mkovero/7226ctrl/schematics.png

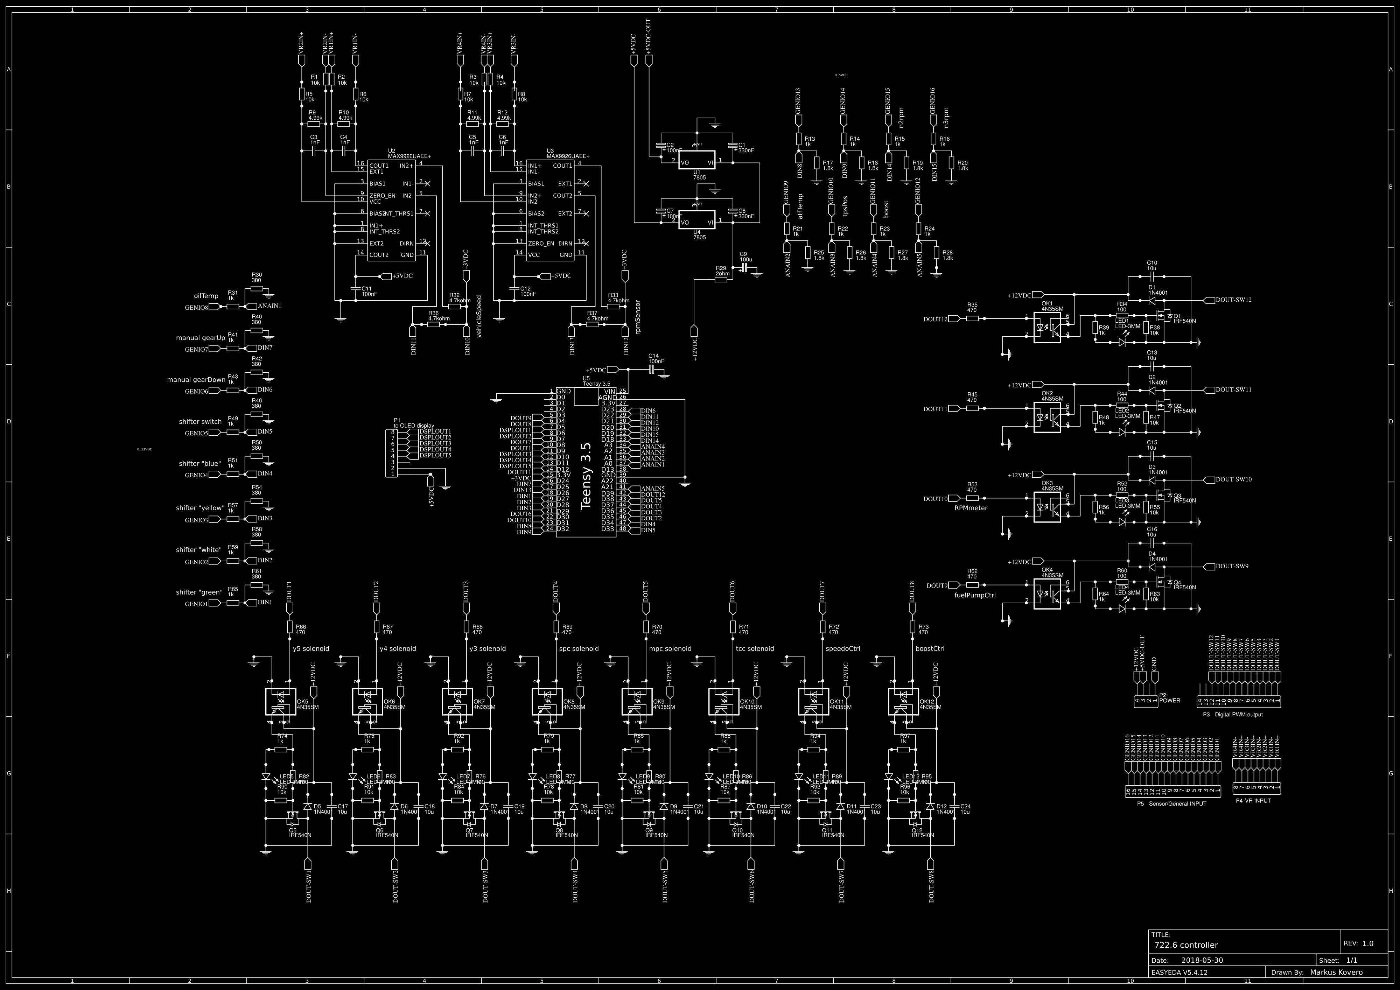
schematics.png
