mkovero/7226ctrl/pcb/bom_K.xls

722SMD2-HIGHPREC
Mouser No | Mfr. No | Manufacturer | Customer No | Description | RoHS | Lifecycle | Order Qty. | Price (EUR) | Ext.: (EUR)
474-DEV-14056 | DEV-14056 | SparkFun Electronics |  | Development Boards & Kits - ARM Teensy 3.5 (Headers) | RoHS Compliant |  | 1 | 28,38 € | 28,38 €
595-CD4504BPWR | CD4504BPWR | Texas Instruments |  | Translation - Voltage Levels Hex Voltage | RoHS Compliant |  | 2 | 0,419 € | 0,84 €
511-L78M05CDT-TR | L78M05CDT-TR | STMicroelectronics |  | Linear Voltage Regulators 5.0V 0.5A Positive | RoHS Compliant |  | 2 | 0,402 € | 0,80 €
700-MAX9926UAEE/V+ | MAX9926UAEE/V+ | Maxim Integrated |  | Sensor Interface Variable-Reluctance Sensor Interface | RoHS Compliant |  | 2 | 10,93 € | 21,86 €
603-RC0603FR-07383RL | RC0603FR-07383RL | Yageo |  | Thick Film Resistors - SMD 383 OHM 1% | RoHS Compliant By Exemption |  | 7 | 0,087 € | 0,61 €
603-RC0603FR-07280RL | RC0603FR-07280RL | Yageo |  | Thick Film Resistors - SMD 280 OHM 1% | RoHS Compliant |  | 1 | 0,087 € | 0,09 €
603-RC0603FR-07220RL | RC0603FR-07220RL | Yageo |  | Thick Film Resistors - SMD 220 OHM 1% | RoHS Compliant By Exemption |  | 1 | 0,087 € | 0,09 €
603-RC0603FR-071K8L | RC0603FR-071K8L | Yageo |  | Thick Film Resistors - SMD 1.8K OHM 1% | RoHS Compliant |  | 8 | 0,087 € | 0,70 €
942-IRF540NSTRLPBF | IRF540NSTRLPBF | Infineon |  | MOSFET MOSFT 100V 33A 44mOhm 47.3nC | RoHS Compliant |  | 12 | 1,09 € | 13,08 €
755-SMLEN3WBC8W1 | SMLEN3WBC8W1 | ROHM Semiconductor |  | Standard LEDs - SMD White 10mA; 120mcd 0603; 10mA; 33mW Pd | RoHS Compliant | New Product | 12 | 0,252 € | 3,02 €
576-AQ4020-01FTG | AQ4020-01FTG | Littelfuse |  | ESD Suppressors / TVS Diodes 30A 2.5pF AEC-Q101 | RoHS Compliant | New Product | 12 | 0,41 € | 4,92 €
621-1N5819HW-F | 1N5819HW-7-F | Diodes Incorporated |  | Schottky Diodes & Rectifiers Vr/40V Io/1A T/R | RoHS Compliant |  | 14 | 0,252 € | 3,53 €
650-MINISMDC110F/24 | MINISMDC110F/24-2 | Littelfuse |  | Resettable Fuses - PPTC 24V 1.1A-HD 40A MAX | RoHS Compliant |  | 2 | 0,445 € | 0,89 €
667-EEU-FR1E102L | EEU-FR1E102L | Panasonic |  | Aluminium Electrolytic Capacitors - Radial Leaded 25VDC 1000uF 10x25mm LS5mm | RoHS Compliant |  | 1 | 0,821 € | 0,82 €
810-CGA4J2X8R1E334KA | CGA4J2X8R1E334K125AE | TDK |  | Multilayer Ceramic Capacitors MLCC - SMD/SMT SOFT 0805 25V 0.33uF X8R 10% AEC-Q200 | RoHS Compliant |  | 2 | 0,279 € | 0,56 €
810-C2012X7T2E104MST | C2012X7T2E104M125AE | TDK |  | Multilayer Ceramic Capacitors MLCC - SMD/SMT SOFT 0805 250V 0.1uF X7T 20% T: 1.25mm | RoHS Compliant |  | 7 | 0,349 € | 2,44 €
810-CGA4C4C0G2W102J0 | CGA4C4C0G2W102J060AE | TDK |  | Multilayer Ceramic Capacitors MLCC - SMD/SMT 0805 C0G 450V 1nF 5% SOFT C0G AEC-Q200 | RoHS Compliant | New Product | 4 | 0,297 € | 1,19 €
603-RC0603FR-072KL | RC0603FR-072KL | Yageo |  | Thick Film Resistors - SMD 2K OHM 1% | RoHS Compliant |  | 16 | 0,016 € | 0,26 €
603-RC0603FR-07100RL | RC0603FR-07100RL | Yageo |  | Thick Film Resistors - SMD 100 OHM 1% | RoHS Compliant |  | 12 | 0,016 € | 0,19 €
603-RC0603FR-074K7L | RC0603FR-074K7L | Yageo |  | Thick Film Resistors - SMD 4.7K OHM 1% | RoHS Compliant |  | 9 | 0,087 € | 0,78 €
603-RC0603FR-0710KL | RC0603FR-0710KL | Yageo |  | Thick Film Resistors - SMD 10K OHM 1% | RoHS Compliant |  | 20 | 0,016 € | 0,32 €
603-RC0603FR-071KL | RC0603FR-071KL | Yageo |  | Thick Film Resistors - SMD 1K OHM 1% | RoHS Compliant |  | 16 | 0,016 € | 0,26 €
