mkovero/7226ctrl/pcb/bom_H.xls

Comment | Description | Designator | Footprint | LibRef | Quantity
330nF |  | C1, C8 | 330NF TDK |  | 2.0
100nF |  | C2, C7, C11, C12, C14 | 0.1UF TDK |  | 5.0
1nF |  | C3, C4, C5, C6 | RAD-0.1 |  | 4.0
1000uF | EEUFR1E102 | C9 | 1000UF PANASONIC |  | 1.0
EXT CONN |  | CANBUS/SERIAL | HDR-4X1/2.54 |  | 1.0
1N4001 |  | D1, D2, D3, D4, D5, D6, D7, D8, D9, D10, D11, D12 | DIODE_DO35 |  | 12.0
to OLED display |  | Display | HDR-8X1/2.54 |  | 1.0
Sensor/General INPUT |  | GENERAL INPUT | HDR1X16 |  | 1.0
LED-3MM |  | LED1, LED2, LED3, LED4, LED5, LED6, LED7, LED8, LED9, LED10, LED11, LED12 | LED-3MM/2.54 |  | 12.0
4N35SM |  | OK1, OK2, OK3, OK4, OK5, OK6, OK7, OK8, OK9, OK10, OK11, OK12 | DIL6-SMD |  | 12.0
VR INPUT2 |  | P6 | HDR-4X1/2.54 |  | 1.0
VR INPUT1 |  | P7 | HDR-4X1/2.54 |  | 1.0
POWER |  | PWR | HDR-4X1/2.54 |  | 1.0
IRF540N |  | Q1, Q2, Q3, Q4, Q5, Q6, Q7, Q8, Q9, Q10, Q11, Q12 | TO-263-2 |  | 12.0
10k |  | R1, R2, R3, R4, R5, R6, R7, R8, R38, R47, R55, R63, R78, R81, R84, R87, R90, R91, R93, R96 | AXIAL-0.3_2 |  | 20.0
4.99k |  | R9, R10, R11, R12 | AXIAL-0.3_2 |  | 4.0
1k |  | R13, R14, R15, R16, R21, R22, R23, R24, R31, R39, R41, R43, R48, R49, R51, R56, R57, R59, R64, R65, R74, R75, R79, R85, R88, R92, R94, R97 | AXIAL-0.3_2 |  | 28.0
1.8k |  | R17, R18, R19, R20, R25, R26, R27, R28 | AXIAL-0.3_2 |  | 8.0
2ohm |  | R29 | AXIAL-0.3_2 |  | 1.0
380 |  | R30, R40, R42, R46, R50, R54, R58, R61 | AXIAL-0.3_2 |  | 8.0
4.7kohm |  | R32, R33, R36, R37 | AXIAL-0.3_2 |  | 4.0
100 |  | R34, R44, R52, R60, R76, R77, R80, R82, R83, R86, R89, R95 | AXIAL-0.3_2 |  | 12.0
470 |  | R35, R45, R53, R62, R66, R67, R68, R69, R70, R71, R72, R73 | AXIAL-0.3_2 |  | 12.0
7805 |  | U1, U4 | TO252 |  | 2.0
MAX9926UAEE+ |  | U2, U3 | QSOP-16_150MIL |  | 2.0
Teensy 3.5 |  | U5 | TEENSY 3.5 |  | 1.0
