mkovero/7226ctrl/(threads)

Thread 1 (2018-02-25):

Schematic - transistors

thundercat, 2018-02-25:
Hi
I have few remark.
IRF540 need Vgs = ~10V to full open
to drive transistor direct from arduino pin you have to use Logic Level mosfet eg. IRFZ44N or use mosfet driver TC4427.
You have to protect transistors by diodes,
swap on schematic drain pin with source pin because now is incorrect.
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

best regards

mkovero, 2018-03-11:
Thanks for feedback, I'm actually using 4 channel mosfet boards on the actual circuit and schematic is guiding so to say. I'll fix this next week accordingly.
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

Thread 2 (2018-06-06):

vehicleSpeed safety checks

mkovero, 2018-06-06:
- compare speed differences in RPM-vehicleSpeed and or differential sensor-vehicleSpeed to determine whether vehicleSpeed is accurate.
- if not, or no speed data available, disable automatic shifting.

mkovero, 2018-06-11:
fixed in https://github.com/mkovero/7226ctrl/commit/2de3873fe0690ee71ed6efa9559b21a33d5eaf03

Closed 2018-06-11.

Thread 4 (2018-06-06):

Create hardware test-mode

mkovero, 2018-06-06:
Idea is to create simple test mode for controller to see if wiring is alright.
- test sensors / solenoids / actuators (test that tps is in range, if not, calibrate it etc.)
- display test / align (support for different displays people might have)

dvjcodec, 2018-11-19:
I use simple sketch for tests outputs in my controller. Just add LCD output with test graphics.
https://drive.google.com/file/d/1jQX9WTmhtOgBZNdRIwTGqzLBBpeP_FXw/view?usp=sharing

int led = 19;   //speed1
int led2 = 18;  //speed2
int led3 = 24;  //speed3
int led4 = 35;  //selenoid1
int led5 = 37;  //selenoid2
int led6 = 41;   //selenoid3
int led7 = 43;  //selenoid4
int led8 = 39;   //selenoid5
int led9 = 29;   //selenoid6
int led10 = 31;   //selenoid7
int led11 = 33;   //selenoid8
int led12 = 2;  //MCP int
int led13 = 0;   //
int led14 = 0;  //
int led15 = 0;  //
int led16 = 0;  //
int led17 = 0;  //
int led18 = 0;  //
int led19 = 0;  //

void setup() {       
// initialize the digital pin as an output.
pinMode(led, OUTPUT);
pinMode(led2, OUTPUT);
pinMode(led3, OUTPUT);
pinMode(led4, OUTPUT);
pinMode(led5, OUTPUT);
pinMode(led6, OUTPUT);
pinMode(led7, OUTPUT);
pinMode(led8, OUTPUT);
pinMode(led9, OUTPUT);
pinMode(led10, OUTPUT);
pinMode(led11, OUTPUT);
pinMode(led12, OUTPUT);
pinMode(led13, OUTPUT);
pinMode(led14, OUTPUT);
pinMode(led15, OUTPUT);
pinMode(led16, OUTPUT);
pinMode(led17, OUTPUT);
pinMode(led18, OUTPUT);
pinMode(led19, OUTPUT);
}

void loop()
{digitalWrite(led, HIGH);   // turn the LED on (HIGH is the voltage level)
delay(50);                 // wait for a second
digitalWrite(led, LOW);     // turn the LED off by making the voltage LOW
delay(50);                 // wait for a second

{digitalWrite(led2, HIGH);
delay(50);
digitalWrite(led2, LOW);
delay(50);}

{digitalWrite(led3, HIGH);
delay(50);
digitalWrite(led3, LOW);
delay(50);}

{digitalWrite(led4, HIGH);
delay(50);
digitalWrite(led4, LOW);
delay(50);}

{digitalWrite(led5, HIGH);
delay(50);
digitalWrite(led5, LOW);
delay(50);}

{digitalWrite(led6, HIGH);
delay(50);
digitalWrite(led6, LOW);
delay(50);}

{digitalWrite(led7, HIGH);
delay(50);
digitalWrite(led7, LOW);
delay(50);}

{digitalWrite(led8, HIGH);
delay(50);
digitalWrite(led8, LOW);
delay(50);}

{digitalWrite(led9, HIGH);
delay(50);
digitalWrite(led9, LOW);
delay(50);}

{digitalWrite(led10, HIGH);
delay(50);
digitalWrite(led10, LOW);
delay(50);}

{digitalWrite(led11, HIGH);
delay(50);
digitalWrite(led11, LOW);
delay(50);}

{digitalWrite(led12, HIGH);
delay(50);
digitalWrite(led12, LOW);
delay(50);}

{digitalWrite(led13, HIGH);
delay(50);
digitalWrite(led13, LOW);
delay(50);}

{digitalWrite(led14, HIGH);
delay(50);
digitalWrite(led14, LOW);
delay(50);}

{digitalWrite(led15, HIGH);
delay(50);
digitalWrite(led15, LOW);
delay(50);}

{digitalWrite(led16, HIGH);
delay(50);
digitalWrite(led16, LOW);
delay(50);}

{digitalWrite(led17, HIGH);
delay(50);
digitalWrite(led17, LOW);
delay(50);}

{digitalWrite(led18, HIGH);
delay(50);
digitalWrite(led18, LOW);
delay(50);}

{digitalWrite(led19, HIGH);
delay(50);
digitalWrite(led19, LOW);
delay(50);}

}

mkovero, 2018-11-19:
thanks for this; INPUTs would require similar functionality, also sensor calibration would need some thought (pressure sensors, tps, temp sensors)

Thread 5 (2018-09-11):

Libraries

ikulic, 2018-09-11:
Hi,can you upload your necessary library folder for that code? I have problem with compiling with last version of Arduino IDE.

mkovero, 2018-09-14:
Hi, Yes I have to check best way to include libraries, external dependencies are as follows:
https://github.com/prampec/arduino-softtimer for softtimer.h
https://github.com/olikraus/u8g2 for U8g2lib.h
http://ryandowning.net/AutoPID/ for AutoPID.h

ikulic, 2018-09-14:
Now it is working,thank you. If you need some help with this project,you can contact me. Now I am working on two 722.6 transmision,I just waiting for pcb to manufacture. I will put that transmission on om606 and we will see.

Closed 2018-09-16.

Thread 13 (2019-02-15):

Pins for Arduino mega?

bendeguztanczos, 2019-02-15:
Hi all! Anyone try it on Arduino mega? I thought I make a full smd board with atmega2560. Anyone have pins.h for arduino mega? And how well it is run on mega or i need teensy?

mkovero, 2019-03-17:
I used to develop this on arduino mega, but unfortunately there are few quite heavy float calculation nowadays and I'm afraid that mega wont perform enough to handle it not to mention it would not have enough available memory to even try to run the code. Teensy 3.5 is highly recommended.

Closed 2019-03-17.

Thread 15 (2019-04-12):

Read gear number from CAN.

Amarok73, 2019-04-12:
Hello Markus,

May I ask You, if You know how to read the gear number, lock-up state and gearbox oil temperature from the CAN (preferably through OBDII)?
I am using Jeep WG with this gearbox for around 3 years now, and since beginning I have idea to prepare Arduino based indicator of these values.
I was trying unsuccessfully to sniff messages and analyze them, and when i lost my hope, there appeared new version of JeepDiagPro, that was showing these values.
I know from Krzysztof Dymaniuk, that it wasn't so far in the scope of Your engineering, but perhaps as You already have all needed facilities it would be easier for You to investigate it?
I'd really appreciate if You can share anything substantial, as this fight with obsession i feel i am loosing slowly... :-)

astam1, 2019-04-23:
Doing this through the ODBII is going to be very difficult. Most likely your vehicle has a module that acts like a gateway from the OBDII to the internal can network(s). This is typically secured so that a sort of "code" is needed. Only standard OBD PIDs will be available via OBDII without the manufacturers "code".

I have an XK that uses the same transmission. Using a tap into the power train bus can tell you in the 06 XK the tcm transmits base 10 can ids 536, 824, 1048, 1312. At least in this application the current gear does not appear to be transmitted on the bus. Most of the messages are not decipherable. Code 824 contains the input shaft speed. In my vehicle there is no manual shift mode, only a mode that selected the highest available gear. The 1,2,3,4,5 displayed on the cluster is simply the highest gear available and is read from the shift control module.

I have used an app called "obd jscan" which is able to get the atf temperature. It works through the obd port. You could possible get the obd2 "code" for your car my sniffing the obd2 port while running the app. At least when I last used it, it didn't show the current gear or lock-up state.

Lastly what is a jeep WG? Did you mean WK, WK2, XK, WK?

Amarok73, 2019-05-13:
Hello @astam1, thank You for Your comment.
Jeep WG is the Grand Cherokee 2 released on European market. The WJ is the same but on the USA.
I have tried couple of scanners, but so far, analyzing the dumps I wasn't able to find anything that could possibly be identified as the messages I am interested about, so I am affraid that these PIDs are only returning values instead of broadcasting these parameters.

astam1, 2019-05-17:
Alright so the vehicle is a diesel WJ with the 722.6? It sounds like you are using the OBDII port to try to get the current transmission gear. It is likely that the PID for current transmission gear is not supported on that vehicle (not supported on mine either). If this is the case there is no easy way to get the current gear.

This information may be on the internal can bus between the TCM and ECU but you would have to splice into it to find out and it may not be available their either. If you are interested in the internal bus you may find [this](http://connectors.dcctools.com/home.htm) useful. If you type in your year and select WJ you can find the connector pinouts. Using this you can locate the can bus that you would need to tap into. Do this at your own risk though.

dvjcodec, 2019-05-19:
Gear number is coded in ID218 (I was read from Mercedes W210 CANbus network). ID218 is Transmission Control Unit.
Sample message --> ID218 6 FE 20 11 40 AA 09
20 - is a shifter position (same like W202)
11 - gear number
40 - no kickdown / with kickdown is 44
AA - probably torque status, because is growing up when car accelerate and stop on AA or 64 when speed stable (doesnt matter what gear).
I have a lot recorded CANbus messages from my car and will put all info on my Github
https://github.com/dvjcodec/Mercedes-W210-CAN-bus

Amarok73, 2019-05-19:
So far, I've found that my Arduino + CanBus Shield "sandwich" is ok (tested successfully on Volvo V40), so reason that it is not returning anything from OBD2 socket seems to be somewhere else. It may be, that CAN pins in socket are disabled - not connected.
I'll try to get CAN signal from radio harness, but still i have feeling, that documentation for these "features" in my Jeep model is really tough to find in the Internet.

dvjcodec, 2019-05-19:
Connect direct to TCU's wires. CAN-bus can't be disabled, because is diagnostic data for all systems in your Jeep WJ. If U have ELM327 U can test connection between OBDII and application. Use free diagnostic software (best for WJ 2.7CRD) --> https://jeepswj.com/software/.
I will try to connect to my W163 tomorrow.

Amarok73, 2019-05-20:
Krzysztof, I mentioned this software in my first post, and yes - it is possible to read all interresting me parameters using this software from OBD2 with Bluetooth interface connected. So in theory it's not needed to connect into any harness, it's just matter of knowing how to read these values from OBD socket. Here are some screenshots from the paid version of the JeepDiag software.
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

dvjcodec, 2019-05-21:
CAN-bus data direct from Transmission Control Unit (EGS52)
53,752 218      8 CC 40 FF 48 13 80 FF 51
53,769 338      8 FF FF 1F FF 00 FF 00 00
53,771 418      8 20 20 82 80 FF FF 7F FF
Tomorrow I will conect to my MB W163 and give U info about where is current gear.

Amarok73, 2019-05-21:
Which one is the PID, 218, 338 and 418?

dvjcodec, 2019-05-23:
My ML do not have CAN pins in OBDII connector (probably WJ 2.7 same). CAN-bus is an internal network between modules, not for diagnostic. All data to ELM327 diagnostic (with current parameters and DTC's is delivered from SAE J1850 pins --> http://www.interfacebus.com/Automotive_SAE_J1850_Bus.html

UKSFM99, 2019-12-08:
Hate to comment on an old issue, but this is luckily possible, depending on what Model car you have.

I'm the author of this project: https://github.com/UKSFM99/W203-canbus, and have actually used gear number reading for 722.6 in the W211/203/209 Series.

The following discoveries I've found on Bus B. Not Can C.

You should be able to read the gear number in CAN  PID 0x0003 (Its bits 12-16).

Additionally, Transmission fluid temperature can be read using PID 0x0222 (bits 0-8 aka Byte 1) within the frame. Doesn't seem to work on my W203 but does on my friends W211.

I am currently trying to reverse engineer Canbus C manually (Isolating the TCM to see what PIDS it sends). Will update if i find anything :)

Hope this helps!

kacperziolo, 2020-02-11:
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

Hi Krzysztof, could you share more informations about W210 AT CAN communication by any chance ? I'm swapping OM613 engine with 722.6 AT to 85' G-class and I need to make selected gear indicator for "tip-tronic" mode. Your data should help me a lot. Thanks you in advance

rnd-ash, 2020-02-15:
your mostly correct there!

I have decoded a Xentry SGS file which shows ALL the IDs stored within the 722.6 controller, there appears to be way more there than what you found out originally.

see here: https://github.com/rnd-ash/W203-canbus/blob/master/DAT_TRANSLATOR/DECODED/w203_w209%20CAN%20C%20ENGLISH.txt

and find the ECU called GS_218h as that's the ID message you found.

note though that all the GS_ ECU can messages are broadcast from the 722.6s controller, so you'll need to implement all of them.

I have opened a second issue here where I've dumped all the msg Params from the controller.

regards

Thread 16 (2019-09-24):

Schematic update for Rev K

bigdaveakers, 2019-09-24:
The schematic needs to be updated to to reflect the rev K board. The BOM is different for this revision and does not match the schematic.

bendeguztanczos, 2019-09-25:
I uploaded it to drive. I work on a new schematic and a pc software for view live data and adjust the controller. If you intrested email me on the drive email. https://drive.google.com/drive/folders/1ryEfBxrVVONnGXfy4Gf4tAIZiEu2R3jR?usp=sharing

bigdaveakers, 2019-09-25:
Thanks!!

Thread 17 (2019-09-29):

SMD Rev K assembled board photos

captncockwash, 2019-09-29:
Could somebody please share close up photos of assembled rev k board.
Finished mine yesterday, only half powered up, I have a dead short somewhere although I currently can’t find it. Would like to check component polarity against a working board before I decide it’s the PCB. Thanks!

captncockwash, 2019-09-30:
Short between PCB layers, cut out trace and used a jumper wire for 12v supply on one side. Fully functional now, will transfer to new board ASAP.

Closed 2019-09-30.

Thread 18 (2019-12-25):

Display pin out

captncockwash, 2019-12-25:
I’m trying to use a 7 pin SPI OLED. Could somebody please clarify the pin function for ‘DISPLAY 1’ to ‘DISPLAY 5’? Clk, MOSI, DC etc.

I’ve looked at the U8G2 stuff but fear I’m just going round and round in circles. Should the display boot as soon as power is applied to the board.

I’m a relative noob when it comes to the code.

Thank you in advance.

mkovero, 2020-02-27:
Are you referring to some pcb pinout or? which revision?

asaner20, 2021-12-22:
I have a similar question. I soldered the board from this github, revision K. I would like to know the pinout for
connect 7pin SPI OLED display. Without the ability to see data in real time, I cannot check the controller. I also have a question, maybe you have a PC program to configure the controller. I am a car enthusiast, I have knowledge of a mechanic, but in programming I am a noob

Thread 19 (2020-02-13):

ALL 722.6 TCU CAN MESSAGES

rnd-ash, 2020-02-13:
I found these ID's from a python script I wrote to decompile data found in Xentry:
https://github.com/rnd-ash/W203-canbus/blob/master/DAT_TRANSLATOR/parse_dat.py

These ID's are broadcast on CANBUS C - The ECU name is just the name of the message in Xentry, but they all come from the GS controller (AKA TCU) - Original text was in German so most of it has been translated :)

The offset and len in the messages are viewed from a big endian position within the can frame, where 0 is byte 0 and 64 is the 8th bit in the 8th byte

ECU NAME: GS_218h, ID: 0x0218. MSG COUNT: 31
	MSG NAME: MTGL_EGS - Motormomentenanf. Toggle 40ms +-10, OFFSET 0, LENGTH 1
	MSG NAME: MMIN_EGS - Engine torque requirment Min, OFFSET 1, LENGTH 1
	MSG NAME: MMAX_EGS - Engine torque requirment Max, OFFSET 2, LENGTH 1
	MSG NAME: M_EGS - Current engine torque, OFFSET 3, LENGTH 13
	MSG NAME: GZC - Target gear, OFFSET 16, LENGTH 4
	MSG NAME: GIC -Current gear, OFFSET 20, LENGTH 4
	MSG NAME: K_S_B - torque converter slipping, OFFSET 24, LENGTH 1
	MSG NAME: K_O_B - torque converter open, OFFSET 25, LENGTH 1
	MSG NAME: K_G_B - torque converter closed, OFFSET 26, LENGTH 1
	MSG NAME: G_G - off road gear, OFFSET 27, LENGTH 1
	MSG NAME: GSP_OK - gear shift program o.k., OFFSET 28, LENGTH 1
	MSG NAME: FW_HOCH - Driving resistance too high, OFFSET 29, LENGTH 1
	MSG NAME: SCHALT - Schaltung, OFFSET 30, LENGTH 1
	MSG NAME: HSM - Manual shift mode active, OFFSET 31, LENGTH 1
	MSG NAME: GET_OK - Transmission ok, OFFSET 32, LENGTH 1
	MSG NAME: KS - Knallstart, OFFSET 33, LENGTH 1
	MSG NAME: ALF - start enabled, OFFSET 34, LENGTH 1
	MSG NAME: GS_NOTL - Gearbox in limp home mode, OFFSET 35, LENGTH 1
	MSG NAME: UEHITZ_GET - Gearbox overheating, OFFSET 36, LENGTH 1
	MSG NAME: KD - Kickdown, OFFSET 37, LENGTH 1
	MSG NAME: FPC_AAD - Driving program for AAD, OFFSET 38, LENGTH 2
	MSG NAME: MPAR_EGS - Motor torque request parity (even parity) OFFSET 40, LENGTH 1
	MSG NAME: DYN1_EGS - Engagement mode / drive torque control, OFFSET 41, LENGTH 1
	MSG NAME: DYN0_AMR_EGS - Engagement mode / drive torque control OFFSET 42, LENGTH 1
	MSG NAME: K_LSTFR - Torque converter lockup free of load, OFFSET 45, LENGTH 1
	MSG NAME: MOT_NAUS_CNF - Confirm bit OFFSET 46, LENGTH 1
	MSG NAME: MOT_NAUS - Engine emergency stop, OFFSET 47, LENGTH 1
	MSG NAME: MKRIECH - creep torque (FF for EGS + CVT), OFFSET 48, LENGTH 8
	MSG NAME: FEHLPRF_ST - Status error check, OFFSET 56, LENGTH 2
	MSG NAME: CALID_CVN_AKT - CALID/CVN transmission active OFFSET 58, LENGTH 1
	MSG NAME: FEHLER - Error number counter, OFFSET 59, LENGTH 5
ECU NAME: GS_338h, ID: 0x0338. MSG COUNT: 2
	MSG NAME: NAB - Gearbox output speed (only 463/461, otherwise FFFF), OFFSET 0, LENGTH 16
	MSG NAME: NTURBINE - Turbine speed (NAG1/NAG2 only), OFFSET 48, LENGTH 16
ECU NAME: GS_418h, ID: 0x0418. MSG COUNT: 17
	MSG NAME: FSC - Driving position, OFFSET 0, LENGTH 8
	MSG NAME: FPC - Driving program, OFFSET 8, LENGTH 8
	MSG NAME: T_GET - Gearbox oil tempurature, OFFSET 16, LENGTH 8
	MSG NAME: ALLRAD - All wheel drive?, OFFSET 24, LENGTH 1
	MSG NAME: FRONT - Front wheel drive [1], Rear wheel drive [0], OFFSET 25, LENGTH 1
	MSG NAME: SCHALT - Schaltung, OFFSET 26, LENGTH 1
	MSG NAME: CVT - Stepless gears[1], Stepped gear [0], OFFSET 27, LENGTH 1
	MSG NAME: MECH - Gear mechanism varient, OFFSET 28, LENGTH 2
	MSG NAME: ESV_BRE - Apply brake when switched on, OFFSET 30, LENGTH 1
	MSG NAME: KD - Kickdown, OFFSET 31, LENGTH 1
	MSG NAME: GZC - Target gear, OFFSET 32, LENGTH 4
	MSG NAME: GIC - Actual gear, OFFSET 36, LENGTH 4
	MSG NAME: M_VERL - Torque loss, OFFSET 40, LENGTH 8
	MSG NAME: FMRADPAR - wheel torque (even parity), OFFSET 48, LENGTH 1
	MSG NAME: FMRADTGL - Factor wheel torque toggle 40ms + -10, OFFSET 49, LENGTH 1
	MSG NAME: WHST - Gear selector lever posititon (NAG, KSG, CVT), OFFSET 50, LENGTH 3
	MSG NAME: FMRAD - Wheel torque factor (FF for KSG), OFFSET 53, LENGTH 11

mkovero, 2020-02-27:
woot, thank you very much for these, will look into this at some point

rnd-ash, 2020-03-11:
no problem! I'm trying to make my own 722.6 TCU for my W203 as a hobby project (not using this code, sorry), but I thought I'd share those :)

Thread 20 (2020-09-19):

Possible collaberation on updated controller for 2001-2011 Mercs

rnd-ash, 2020-09-19:
Hi.

As you know, I posted all the 722.6 CAN messages to another issue on here. I would like to ask if you are up for collaborating on a more modern drop in replacement TCU for the 203-204 series vehicles (Basically anything with a 722.6 from 2001 to 2011).

I had some ideas on how to update your codebase for CAN compatibility, but it will also require PCB modifications to allow for CAN C Tx/Rx support.

I also wish to add adaptive learning based on a simple neural network that can run on the Teensy 4 board, and allow it to be trained in pure manual mode (M), the apply the learned values in both Sport, Comfort, or Agility mode (A is supported on all 722.6 transmissions, but it was only implemented on the 204 chassis). Due to it being on CANBUS, its possible to take into consideration a lot more sensors on the car before determining if it should shift. Just some of whats avaliable on CANBUS below:
1. Individual wheel RPM (all 4)
2. Steering wheel angle (Driver input)
3. Steering wheel angle (Wheel output)
4. Boost pressure
5 .Engine torque production (Nm)
6. ESP / ABS actuation values

In regards to determining shift pressure. I can make that user configurable in each mode (S/C/A), in fact i plan to enable configuration over CANBUS for my Headunit project, allowing me to adjust shift parameters from a touch screen within the car.

I've also updated the CAN messages below with data extracted from my MercedesUI project (Custom infotainment system for older mercs)...This contains additional parsed values for enum based data:
[7226_can.txt](https://github.com/mkovero/7226ctrl/files/5250090/7226_can.txt)

mkovero, 2020-11-21:
Excellent idea, can rx/tx already works but is restricted to single channel currently. We have been considering doing hardware / software redesign, so if you feel you are up to it you can create algorithm of your own that we can try.
I would prefer pure c++ instead of arduino and use of FreeRTOS helpers so realtime priorisation can be made properly. Refrain from using any interrupts or hardware timers too.
I'm really fond myself of M7 so it's probably going to be used no matter what happens. :>

rusefillc, 2022-01-16:
``I would prefer pure c++ instead of arduino and use of FreeRTOS helpers so realtime priorisation can be made properly. Refrain from using any interrupts or hardware timers too.``

that sounds like rusEFI hybrid timer but we use ChibiOS :)

Thread 21 (2021-10-31):

compilation error

grabula, 2021-10-31:
Arduino:1.8.16 (Mac OS X), TD: 1.55, Płytka:"Teensy 3.5, Serial, 120 MHz, Faster, US English"

/private/var/folders/zj/vq9z9vvx4r7fwmdkt_43ng6w0000gn/T/AppTranslocation/675F2C8C-30CE-4822-B6C4-8DD2C2BAAA7E/d/Teensyduino.app/Contents/Java/hardware/teensy/avr/libraries/TeensyThreads/TeensyThreads.cpp:29:25: fatal error: utils/debug.h: No such file or directory
compilation terminated.
Błąd kompilacji dla płytki Teensy 3.5.

All libraries installed:

Użycie biblioteki SoftTimer w wersji 3.1.3 z folderu: /Users/michalgrabinski/Documents/Arduino/libraries/SoftTimer
Użycie biblioteki EEPROM w wersji 2.0 z folderu: /private/var/folders/zj/vq9z9vvx4r7fwmdkt_43ng6w0000gn/T/AppTranslocation/675F2C8C-30CE-4822-B6C4-8DD2C2BAAA7E/d/Teensyduino.app/Contents/Java/hardware/teensy/avr/libraries/EEPROM
Użycie biblioteki SPI w wersji 1.0 z folderu: /private/var/folders/zj/vq9z9vvx4r7fwmdkt_43ng6w0000gn/T/AppTranslocation/675F2C8C-30CE-4822-B6C4-8DD2C2BAAA7E/d/Teensyduino.app/Contents/Java/hardware/teensy/avr/libraries/SPI
Użycie biblioteki U8g2 w wersji 2.31.2 z folderu: /Users/michalgrabinski/Documents/Arduino/libraries/U8g2
Użycie biblioteki AutoPID w wersji 1.0.3 z folderu: /Users/michalgrabinski/Documents/Arduino/libraries/AutoPID
Użycie biblioteki IFCT-master z folderu /Users/michalgrabinski/Documents/Arduino/libraries/IFCT-master (legacy)
Użycie biblioteki Adafruit_MAX31855_library w wersji 1.3.0 z folderu: /Users/michalgrabinski/Documents/Arduino/libraries/Adafruit_MAX31855_library
Użycie biblioteki Adafruit_BusIO w wersji 1.9.3 z folderu: /Users/michalgrabinski/Documents/Arduino/libraries/Adafruit_BusIO
Użycie biblioteki Filters-master z folderu /Users/michalgrabinski/Documents/Arduino/libraries/Filters-master (legacy)
Użycie biblioteki PciManager w wersji 2.1.4 z folderu: /Users/michalgrabinski/Documents/Arduino/libraries/PciManager
Użycie biblioteki Wire w wersji 1.0 z folderu: /private/var/folders/zj/vq9z9vvx4r7fwmdkt_43ng6w0000gn/T/AppTranslocation/675F2C8C-30CE-4822-B6C4-8DD2C2BAAA7E/d/Teensyduino.app/Contents/Java/hardware/teensy/avr/libraries/Wire
Użycie biblioteki TeensyThreads w wersji 1.0.1 z folderu: /private/var/folders/zj/vq9z9vvx4r7fwmdkt_43ng6w0000gn/T/AppTranslocation/675F2C8C-30CE-4822-B6C4-8DD2C2BAAA7E/d/Teensyduino.app/Contents/Java/hardware/teensy/avr/libraries/TeensyThreads

lplp12, 2021-12-11:
if you google that error I think you will find the fix, it is not specific to 7226ctrl its a teensy library problem I think. sorry I can't find it right now. but I had the they same.

Thread 22 (2021-11-10):

Current gear always resets to first

tboHammu, 2021-11-10:
We've built one of these controllers (rev.K) and installed it in a '98 E300TD with the old-style shifter. It seems to be somewhat functioning, however we are facing an issue where is you shift say from 1st gear through 5th in manual-mode, let it sit for a while and then try to shift, suddenly the controller thinks it is in 1st gear all of a sudden. Got any pointers on what could be wrong here, some sensor input or? Surely something has to be ways off?

Thread 23 (2022-07-06):

Discord Chat

GreJef04, 2022-07-06:
I am interested in building one of these. I am hardly a coder, I can definitely assemble a PCB and flash microcontrollers. I read that you are looking for someone to write instructions. I think this is something I could do well. Is there a group chat where we can communicate more quickly? I often use Discord for things like this, but would readily adopt another platform.

One of my interests for my 1995 E300D (aside from ditching the 722.4) is implementing a VGT boost controller using a vacuum controlled VGT from the OM648. I do wonder if this controller could operate a purge flow solenoid to modulate the vacuum signal to the VGT actuator.

Thread 25 (2023-12-21):

Working alternatives to teensy 3.5?

runesmdk, 2023-12-21:
As the teensy 3.5 is end of life, are there known working alternatives?

Zawoska, 2025-03-04:
You could use the teensy 4.1, the incoming signals from 0-5 volts are going to be approximately 3.3 volt because of the resistor.
