mkovero/7226ctrl/main/maps.cpp

//Automatic mode autoGear map
static const int gearMap[14][12] PROGMEM {
{999,        0,   10,   20,   30,   40,   50,   60,   70,   80,   90,   100 },   //throttle position %
//-----------------------------------------------------------------------
{   0,       2,    2,    2,    2,    2,    2,    2,    2,    2,    2,    2 },
{  10,       2,    2,    2,    2,    2,    2,    2,    2,    2,    2,    2 },
{  20,       3,    3,    3,    3,    3,    3,    2,    2,    2,    2,    2 },
{  30,       3,    3,    3,    3,    3,    3,    3,    2,    2,    2,    2 },
{  45,       4,    4,    4,    4,    4,    4,    4,    3,    3,    3,    3 },
{  50,       4,    4,    4,    4,    4,    4,    4,    3,    3,    3,    3 },
{  60,       5,    5,    5,    5,    5,    5,    5,    4,    4,    4,    4 },
{  70,       5,    5,    5,    5,    5,    5,    5,    5,    5,    4,    4 },
{  80,       5,    5,    5,    5,    5,    5,    5,    5,    5,    4,    4 },
{  90,       5,    5,    5,    5,    5,    5,    5,    5,    5,    4,    4 },
{ 100,       5,    5,    5,    5,    5,    5,    5,    5,    5,    4,    4 },
{ 110,       5,    5,    5,    5,    5,    5,    5,    5,    5,    5,    5 },
{ 120,       5,    5,    5,    5,    5,    5,    5,    5,    5,    5,    5 }};
//vehicle speed, km/h

//MPC map in normal drive (=outside shifts. This is just to make a better mileage, MPC pressure could be 100% outside shifts too.)
static const int mpcNormalMap[14][12] PROGMEM {
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
{  80,       8,   13,   18,   18,   23,   50,   75,   85,   85,   90,  100 },
{  90,       8,   13,   18,   18,   23,   50,   75,   85,   85,   90,  100 },
{ 100,       8,   13,   18,   18,   23,   50,   75,   85,   85,   90,  100 }};
//oil temp
