mkovero/7226ctrl/(commit log)

2017-12-04 Added rudimentary RPM check via interrupts (pins 2,3,21)
2018-01-06 Documentation, more defined pinout, SPI display support
2018-01-13 Logic fixes, spc pulse, PNR gearup/down block, PNR to display
    [main.ino]
2018-01-13 moar constant variables, fixups
    [main.ino]
2018-01-15 Cleaning a bit, wantedGear -> newGear logic for gear lapping more than one gear.
2018-01-15 Added debug, cleanup in switchGear
2018-01-16 N2/N3 speed sensor support, pins 19/20 used for interrupts
2018-01-17 solenoids works, display works and stick works in real life setup, had to do couple ugly workarounds.
    [main.ino]
2018-01-22 boost/tps map linearisation and sensor reads, vehicleSpeed interrupt handling
2018-02-07 gear shift rewrite
2018-02-10 automatic gearshift, pressure maps, gear maps with function logic from Tuomas Kantola's work.
2018-02-14 after split verify fix
    [main.ino]
2018-02-14 default full mpc pressure off
2018-02-15 Better debug, sensormap reading -> map(), more information on display
2018-02-15 fixed debug a bit, oom.
    [main.ino]
2018-02-19 fullAuto switch, pwm tweaks
2018-02-19 pwm tweaks
2018-02-19 schematics update
2018-02-19 updated schematics
2018-02-25 atf sensor smoothing
2018-03-03 boost pressure control during shifts in relation to tps
2018-03-08 pressure control + cleanup + pollstick middle fix
2018-03-20 starting support for teensy, separating modules with proper extensions
2018-03-29 teensy compat
2018-03-29 pin compat for teensy
2018-05-02 Fuel pump ctrl, tested w124 speedo ctrl working
2018-05-12 readMapInt+shiftPending+pendingGear+fuelMaxRPM+sensor and config-structs
2018-05-14 vehicleSpeed calculations, gearFromRatio() and ratioFromGear()
2018-05-18 initial raspberry setup script, rpmsensor mods
2018-05-29 documentation, debug, new schematics
2018-06-04 u8glib -> u8g2 for teensy compat
2018-06-18 cleanup, teensy specific changes
2018-06-18 rpm/diff/n2/n3 sensor waveform gen testing
2018-07-18 input stick flare fix
    [input.cpp, ui.cpp]
2018-07-30 testing changes and first version of pcb layout
    [bom.xls]
2018-07-30 fix compile time errors
    [core.cpp, eeprom.cpp, input.cpp, pins.h, sensors.cpp, ui.cpp]
2018-07-31 PID boost control
2018-08-09 PID control, per gear boost limits, radio receiver support
2018-08-09 Electric steering wheel ctrl
2018-08-09 horn support, removal of unnecessary resistance convert
2018-08-15 UI menu support, steering wheel menu prev/next, runtesting
2018-08-22 correct manual gear up/down pins
    [pins.h]
2018-08-22 manual gear logic fix
    [input.cpp]
2018-08-22 Default fullAuto = false, W/S switch to control stick ctrl / manual ctrl
2018-08-23 Runtime testing, radiolink testing, temp sensor tweaks
2018-08-24 pollkeys fix, new stenhart coef
    [config.cpp, input.cpp, sensors.cpp, ui.cpp]
2018-08-26 runtesting, 2nd menu page, force gear=2 on P/N, non-blocking radioControl(), debug fixes, shift indicator
    [calc.cpp, config.cpp, core.cpp, input.cpp, main.ino, sensors.cpp, ui.cpp]
2018-09-05 steering: issue serial flush after message
    [main.ino]
2018-09-05 sensor voltage fixes
2018-09-05 steering debounce
2018-09-05 pressure handling changes
2018-09-05 steering debounce continues
2018-09-06 boost voltage check
2018-09-06 tire profile change
2018-09-06 temp sensor tweaks
2018-09-06 move steering main.ino
2018-09-09 PID sanity
2018-09-10 core: apc optional, fix broken calculation
    [core.cpp]
2018-09-12 arduino include
2018-09-13 tcc tuning, new page for buttons
2018-09-13 ratio interrupt work
2018-09-16 gearSlip() calculation
2018-09-16 steering debounce only for shift buttons
2018-09-16 gearSlip calculation and ui mods
2018-09-16 gearslip() includes
2018-09-17 infoDisplay & compile fixes
    [core.cpp, sensors.cpp, ui.cpp]
2018-09-24 gearSlip typofix
2018-10-09 add sensors struct to evalGear
2018-11-01 batterymonitor initial
2018-11-01 horn, exhaustTemp/pressure sensors, started to deprecate MEGA
2018-11-01 datalogging exhaust pressure and pressure differential
2018-11-04 faultmon for slip and battery voltage
    [config.cpp, core.cpp, input.cpp, main.ino, ui.cpp]
2018-11-05 temp calibration for revK
2018-11-10 preshift condition bug, manual shifting overshift fixes
    [core.cpp, input.cpp]
2018-11-14 configurable first tcc gear
2018-11-14 tccLock feature enable, min. gear check
2018-11-15 n2/n3speed sensor pull-up conf
2018-11-19 boost voltage calibration
2018-12-10 filtering on temp sensors
2018-12-15 pollkeys: manual debounce fix
    [input.cpp]
2018-12-19 Add new test data and refactor accordingly
    [ajo.csv]
2018-12-19 switch to 720p
2018-12-19 switch orientation
2018-12-19 Revert "switch orientation"
    This reverts commit 4a158abdbf0c84735eef74f458df7067d9dc1760.
2018-12-31 latest smd pcb gerbers and updated readme
    [bom_H.xls, bom_K.xls]
2019-01-15 Map atf temp sensor for easier mods
2019-01-15 runtest calibration
2019-01-17 TPS calibration code / menu support
2019-01-17 tpsInitPhase1,2 for staged reset
    [calc.cpp, input.cpp, sensors.cpp, ui.cpp]
2019-01-17 runtest sensor calib
2019-01-24 tps calibration
2019-01-24 oiltemp sensor as map based
2019-01-24 speed & rpm sensor read 1hz->10hz
2019-01-26 inverted temp maps support
    [calc.cpp]
2019-02-01 exhaustpressure sensor support
2019-02-04 Implement pressure values from Toni Lassila's VaLas if no sensor values
2019-02-09 shiftdelay without sensor data, fix inverted maps reads
    [calc.cpp, input.cpp]
2019-02-10 Visualization mvp (#12)
    This implements the basic visualization with the following features:
    * Improved stream graph visualization (colors are still somewhat off)
    * Swipeable views to toggle between stream graph and gauges
    * Gauges for speed, rpm and boost pressure
2019-03-05 extern exhaustTempsensor, typofixes, stray 307 fix
    [pins.h, sensors.cpp, serial_config.cpp, ui.cpp]
2019-03-27 Meter page improvements (#14)
    * Set csv loop interval to 30ms
    * Some refactoring, adding bootstrap and moving gauges into row
    * Reformat css-files consistently
    * Add initial version of temperature bar charts
    * Remove obsolete color interpolation from stream graph
2019-03-28 pressureNormalization, injectControl PID
2019-03-29 tps calibration fix
2019-04-08 pressureModifier as float
2019-04-12 tps with ref voltage
2019-04-12 sensor ref voltages, maps
2019-04-20 temp sensors rewrite
2019-04-23 formatting, removal slipFault from boostCtrl
    [input.cpp, sensors.cpp]
2019-04-23 battery calibration
2019-04-23 Less fancier boostCtrl with pid
2019-04-23 Pulldown boostCtrl pin
2019-04-23 Make !tps pressures configurable
2019-05-01 manual feature bypass fix
    [input.cpp, main.ino, serial_config.cpp]
2019-05-01 maps.h, increased 1->2, 2->1 pressures
2019-05-01 increase 4->5 pressure a bit
2019-05-21 Support for different displays, resistiveStick
2019-05-24 displaytype fix, oiltemp calibration
    [main.ino, sensors.cpp, ui.cpp]
2019-06-26 sensors.cpp 100ms->1000ms interval
2019-11-20 revert display re-initialization, broken.
    [ui.cpp]
2020-06-29 W220 CANBUS support
2020-06-29 rpm limit bug fix if no rpm sensor
    [serial_config.cpp]
2020-06-29 IFCT library for canbus
2020-07-07 canbus typo fix
